ME-IRL/goodwatch/hardware/goodwatch31/goodwatch31.kicad_pcb

## KiCad design hardware/goodwatch31/goodwatch31.kicad_pcb (2022-09-20)

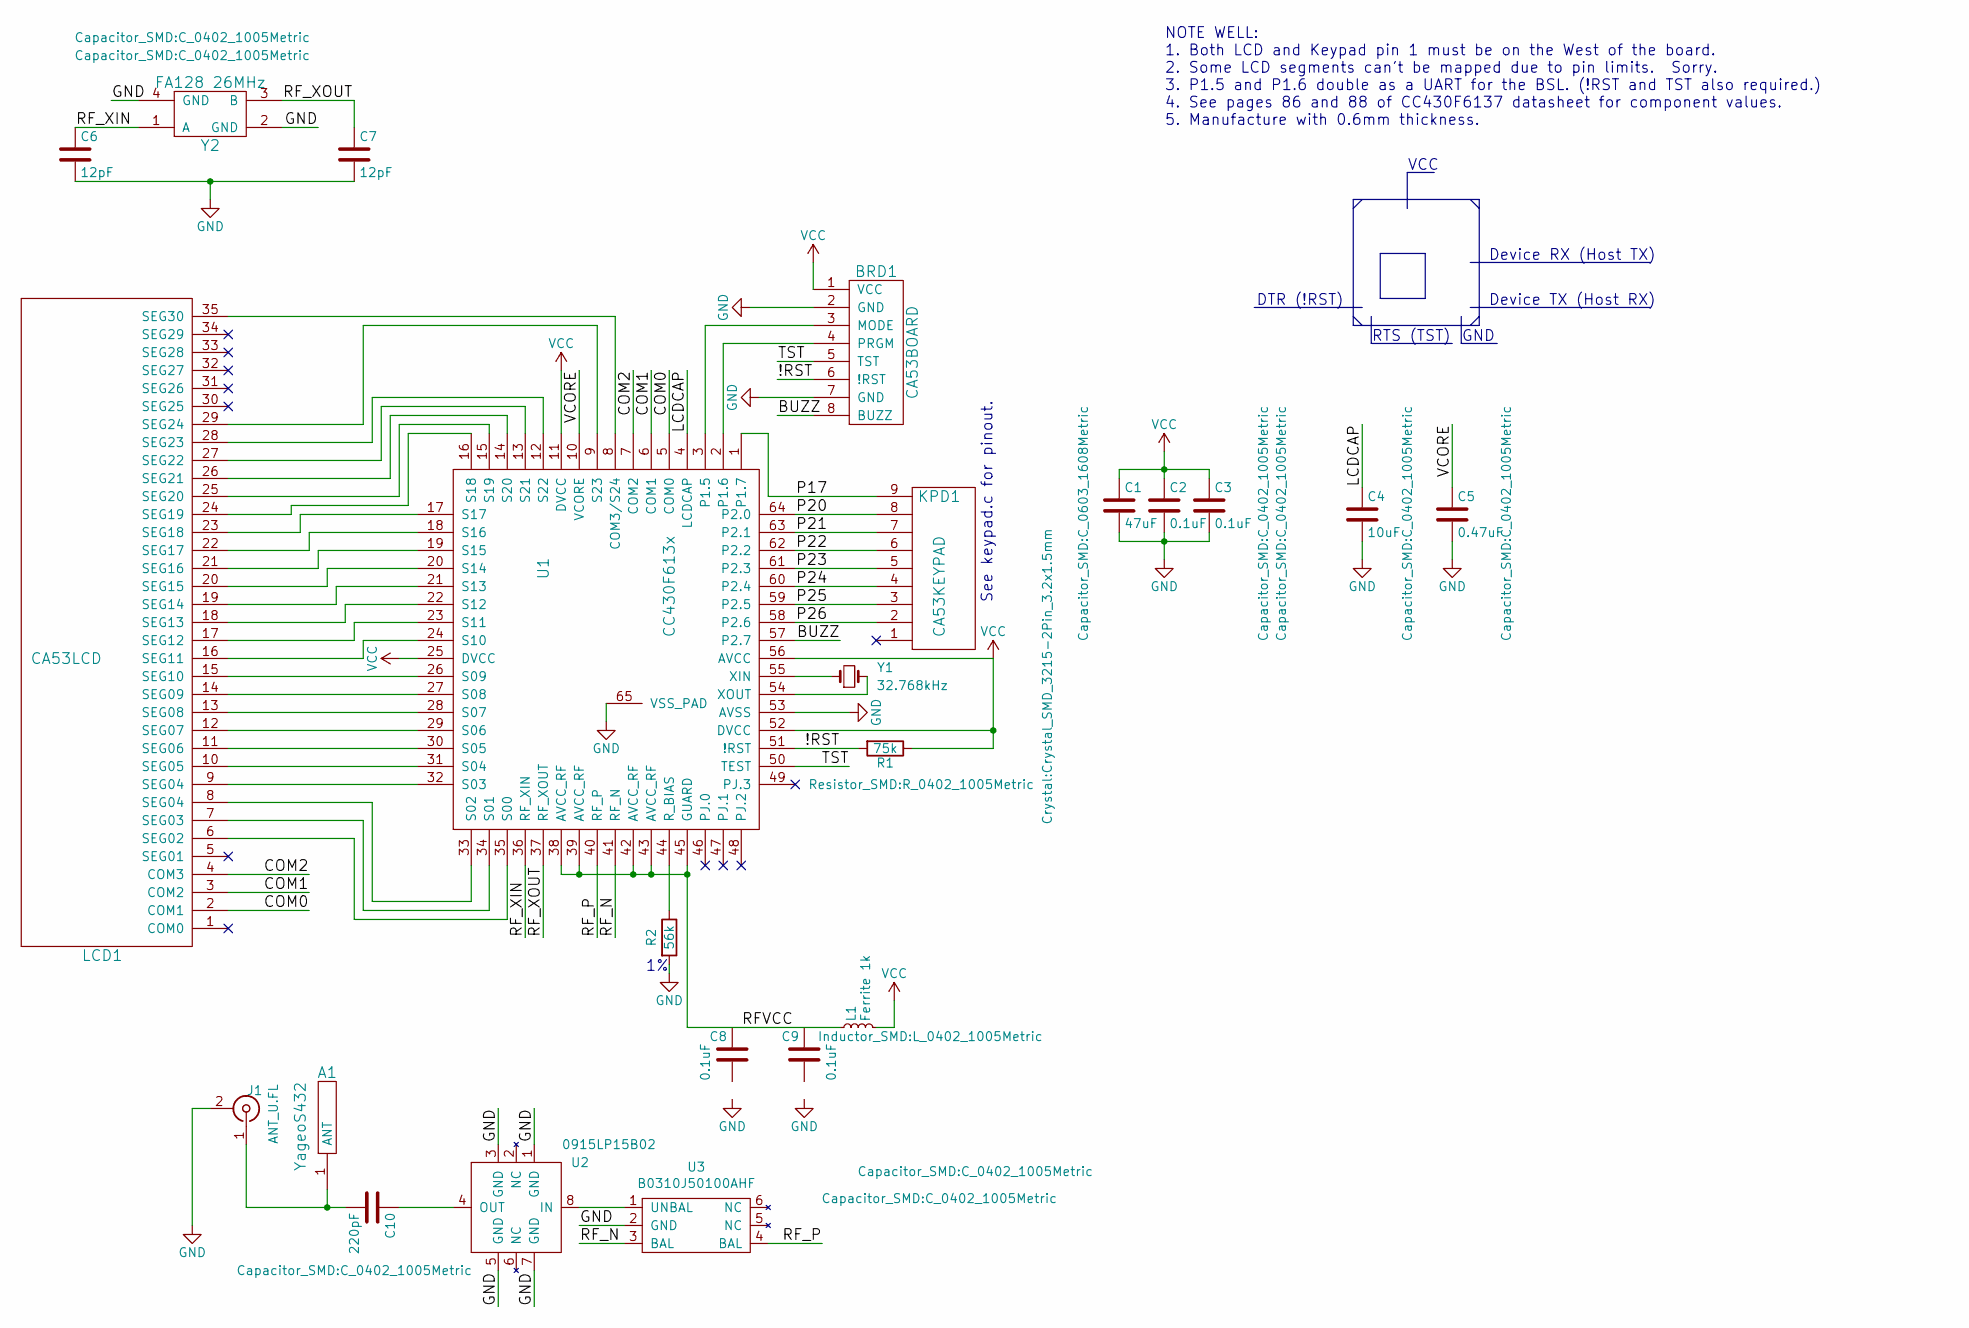
[picture p1: schematic goodwatch31.kicad_sch, GoodWatch]

Parts:
A1: YageoS432
BRD1: CA53BOARD; ca53board
C1: 47uF; C_0603_1608Metric
C2, C3, C8, C9: 0.1uF; C_0402_1005Metric
C4: 10uF; C_0402_1005Metric
C5: 0.47uF; C_0402_1005Metric
C6, C7: 12pF; C_0402_1005Metric
C10: 220pF; C_0402_1005Metric
J1: ANT_U.FL; U.FL_Molex_MCRF_73412-0110_Vertical
KPD1: CA53KEYPAD; ca53keypad
L1: Ferrite 1k; L_0402_1005Metric
LCD1: CA53LCD; ca53lcd
R1: 75k; R_0402_1005Metric
R2: 56k; R_0402_1005Metric
U1: CC430F613x
U2: 0915LP15B02; LP15
U3: B0310J50100AHF
Y1: 32.768kHz; Crystal_SMD_3215-2Pin_3.2x1.5mm
Y2: FA128 26MHz; FA128

Connections:
/!RST: BRD1.6 (!RST), R1.2, U1.51 (!RST)
/BUZZ: BRD1.8 (BUZZ), U1.57 (P2.7)
/COM0: LCD1.2 (COM1), U1.5 (COM0)
/COM1: LCD1.3 (COM2), U1.6 (COM1)
/COM2: LCD1.4 (COM3), U1.7 (COM2)
/LCDCAP: C4.1, U1.4 (LCDCAP)
/RFVCC: C8.1, C9.1, L1.1, U1.38 (AVCC_RF), U1.39 (AVCC_RF), U1.42 (AVCC_RF), U1.43 (AVCC_RF), U1.45 (GUARD)
/RF_N: U1.41 (RF_N), U3.3 (BAL)
/RF_P: U1.40 (RF_P), U3.4 (BAL)
/RF_XIN: C6.1, U1.36 (RF_XIN), Y2.1 (A)
/RF_XOUT: C7.1, U1.37 (RF_XOUT), Y2.3 (B)
/TST: BRD1.5 (TST), U1.50 (TEST)
/VCORE: C5.1, U1.10 (VCORE)
GND: BRD1.2 (GND), BRD1.7 (GND), C1.2, C2.2, C3.2, C4.2, C5.2, C6.2, C7.2, C8.2, C9.2, J1.2 (Ext), R2.2, U1.53 (AVSS), U1.65 (VSS_PAD), U2.1 (GND), U2.3 (GND), U2.5 (GND), U2.7 (GND), U3.2 (GND), Y2.2 (GND), Y2.4 (GND)
unnamed: A1.1, C10.2, J1.1 (In)
unnamed: BRD1.3 (MODE), U1.3 (P1.5)
unnamed: BRD1.4 (PRGM), U1.2 (P1.6)
unnamed: C10.1, U2.4 (OUT)
unnamed: KPD1.2, U1.58 (P2.6)
unnamed: KPD1.3, U1.59 (P2.5)
unnamed: KPD1.4, U1.60 (P2.4)
unnamed: KPD1.5, U1.61 (P2.3)
unnamed: KPD1.6, U1.62 (P2.2)
unnamed: KPD1.7, U1.63 (P2.1)
unnamed: KPD1.8, U1.64 (P2.0)
unnamed: KPD1.9, U1.1 (P1.7)
unnamed: LCD1.6 (SEG02), U1.35 (S00)
unnamed: LCD1.7 (SEG03), U1.34 (S01)
unnamed: LCD1.8 (SEG04), U1.33 (S02)
unnamed: LCD1.9 (SEG04), U1.32 (S03)
unnamed: LCD1.10 (SEG05), U1.31 (S04)
unnamed: LCD1.11 (SEG06), U1.30 (S05)
unnamed: LCD1.12 (SEG07), U1.29 (S06)
unnamed: LCD1.13 (SEG08), U1.28 (S07)
unnamed: LCD1.14 (SEG09), U1.27 (S08)
unnamed: LCD1.15 (SEG10), U1.26 (S09)
unnamed: LCD1.16 (SEG11), U1.24 (S10)
unnamed: LCD1.17 (SEG12), U1.23 (S11)
unnamed: LCD1.18 (SEG13), U1.22 (S12)
unnamed: LCD1.19 (SEG14), U1.21 (S13)
unnamed: LCD1.20 (SEG15), U1.20 (S14)
unnamed: LCD1.21 (SEG16), U1.19 (S15)
unnamed: LCD1.22 (SEG17), U1.18 (S16)
unnamed: LCD1.23 (SEG18), U1.17 (S17)
unnamed: LCD1.24 (SEG19), U1.16 (S18)
unnamed: LCD1.25 (SEG20), U1.15 (S19)
unnamed: LCD1.26 (SEG21), U1.14 (S20)
unnamed: LCD1.27 (SEG22), U1.13 (S21)
unnamed: LCD1.28 (SEG23), U1.12 (S22)
unnamed: LCD1.29 (SEG24), U1.9 (S23)
unnamed: LCD1.35 (SEG30), U1.8 (COM3/S24)
unnamed: R2.1, U1.44 (R_BIAS)
unnamed: U1.54 (XOUT), Y1.2
unnamed: U1.55 (XIN), Y1.1
unnamed: U2.8 (IN), U3.1 (UNBAL)
VCC: BRD1.1 (VCC), C1.1, C2.1, C3.1, L1.2, R1.1, U1.11 (DVCC), U1.25 (DVCC), U1.52 (DVCC), U1.56 (AVCC)

Notes on the sheet:
Device TX (Host RX)
NOTE WELL: 1. Both LCD and Keypad pin 1 must be on the West of the board. 2. Some LCD segments can't be mapped due to pin limits. Sorry. 3. P1.5 and P1.6 double as a UART for the BSL. (!RST and TST also required.) 4. See pages 86 and 88 of CC430F6137 datasheet for component values. 5. Manufacture w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
RTS (TST)
VCC
See keypad.c for pinout.
GND
DTR (!RST)
Device RX (Host TX)

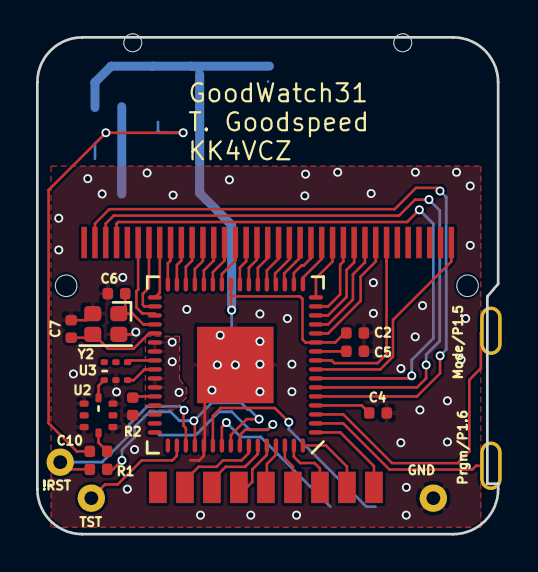
[picture p2: board goodwatch31.kicad_pcb from above]

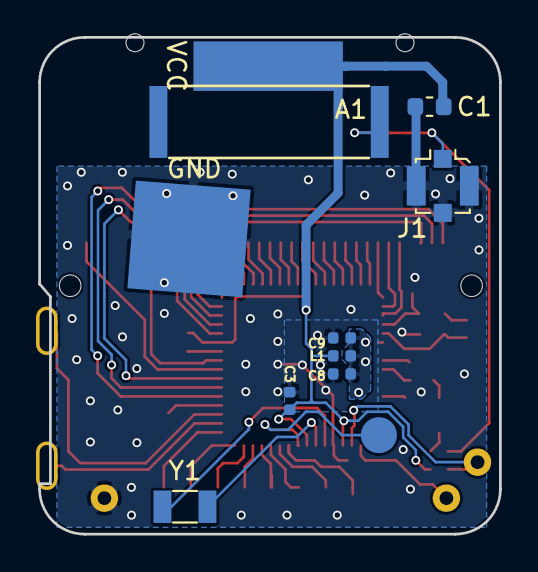
[picture p3: board goodwatch31.kicad_pcb from below]

Board: 2 copper layers, 25.6 x 27.6 mm, 23 parts (8 on the bottom side), 56 nets.
